Chisfamily/GB-Link-USB-Hardware/hw/v1.4/GB-LINK-v1.4.pdf

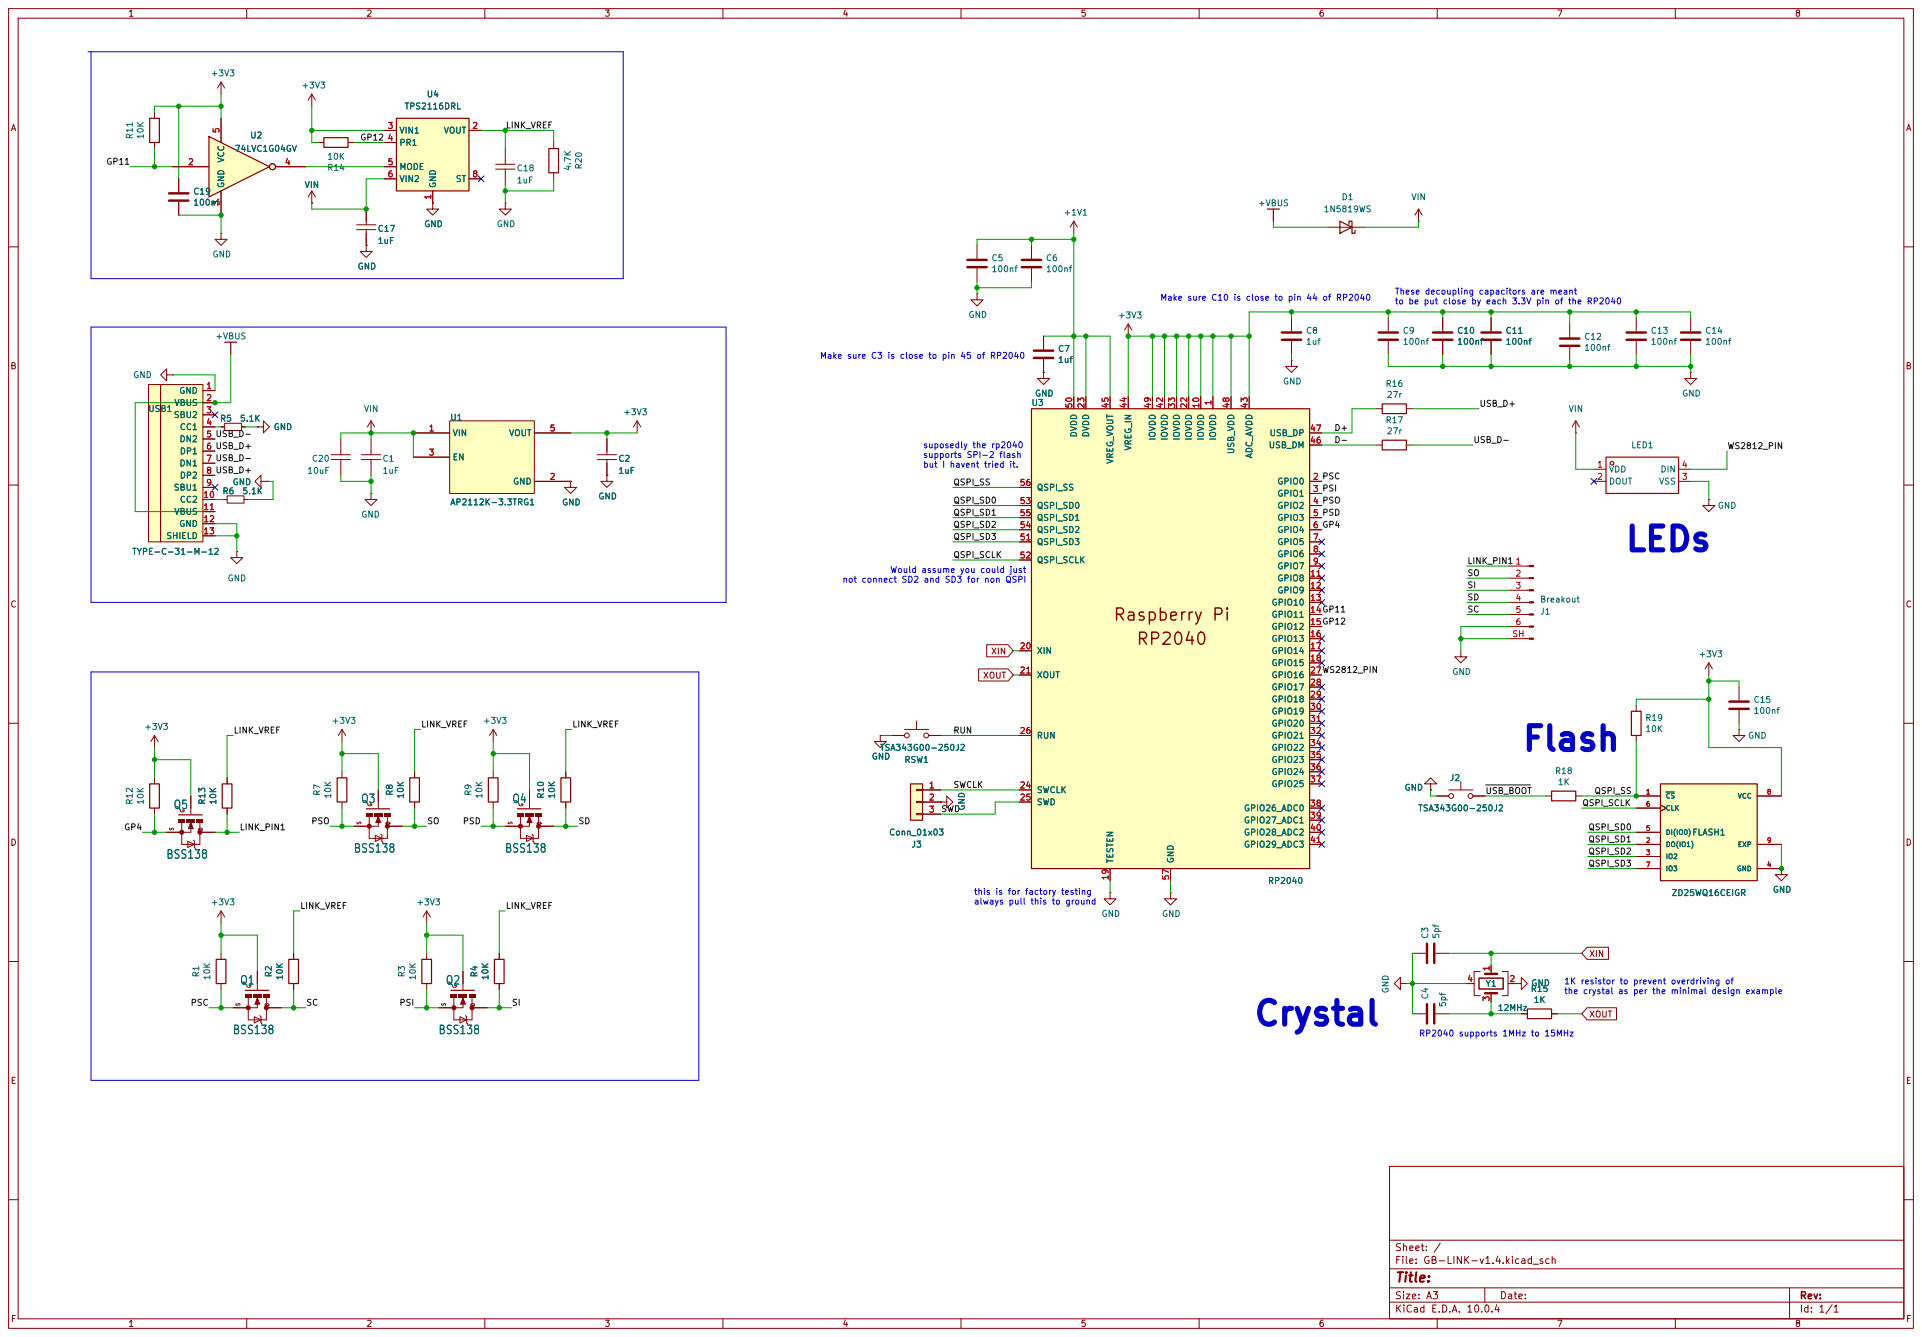
[picture p6: page 1]

These decoupling capacitors are meant
to be put close by each 3.3V pin of the RP2040

Crystal RP2040 supports 1MHz to 15MHz Would assume you could just not connect SD2 and SD3 for non QSPI Make sure C3 is close to pin 45 of RP2040

suposedly the rp2040
supports SPI-2 flash
but I havent tried it.

this is for factory testing
always pull this to ground

1K resistor to prevent overdriving of
the crystal as per the minimal design example

Size: A3 | Rev:
KiCad E.D.A. 10.0.4 | Id: 1/1 | F Date:
