Chisfamily/GB-Link-USB-Hardware/hw/v1.4/GB-LINK-v1.4.kicad_pcb

## KiCad design hw/v1.4/GB-LINK-v1.4.kicad_pcb (2026-10-19)

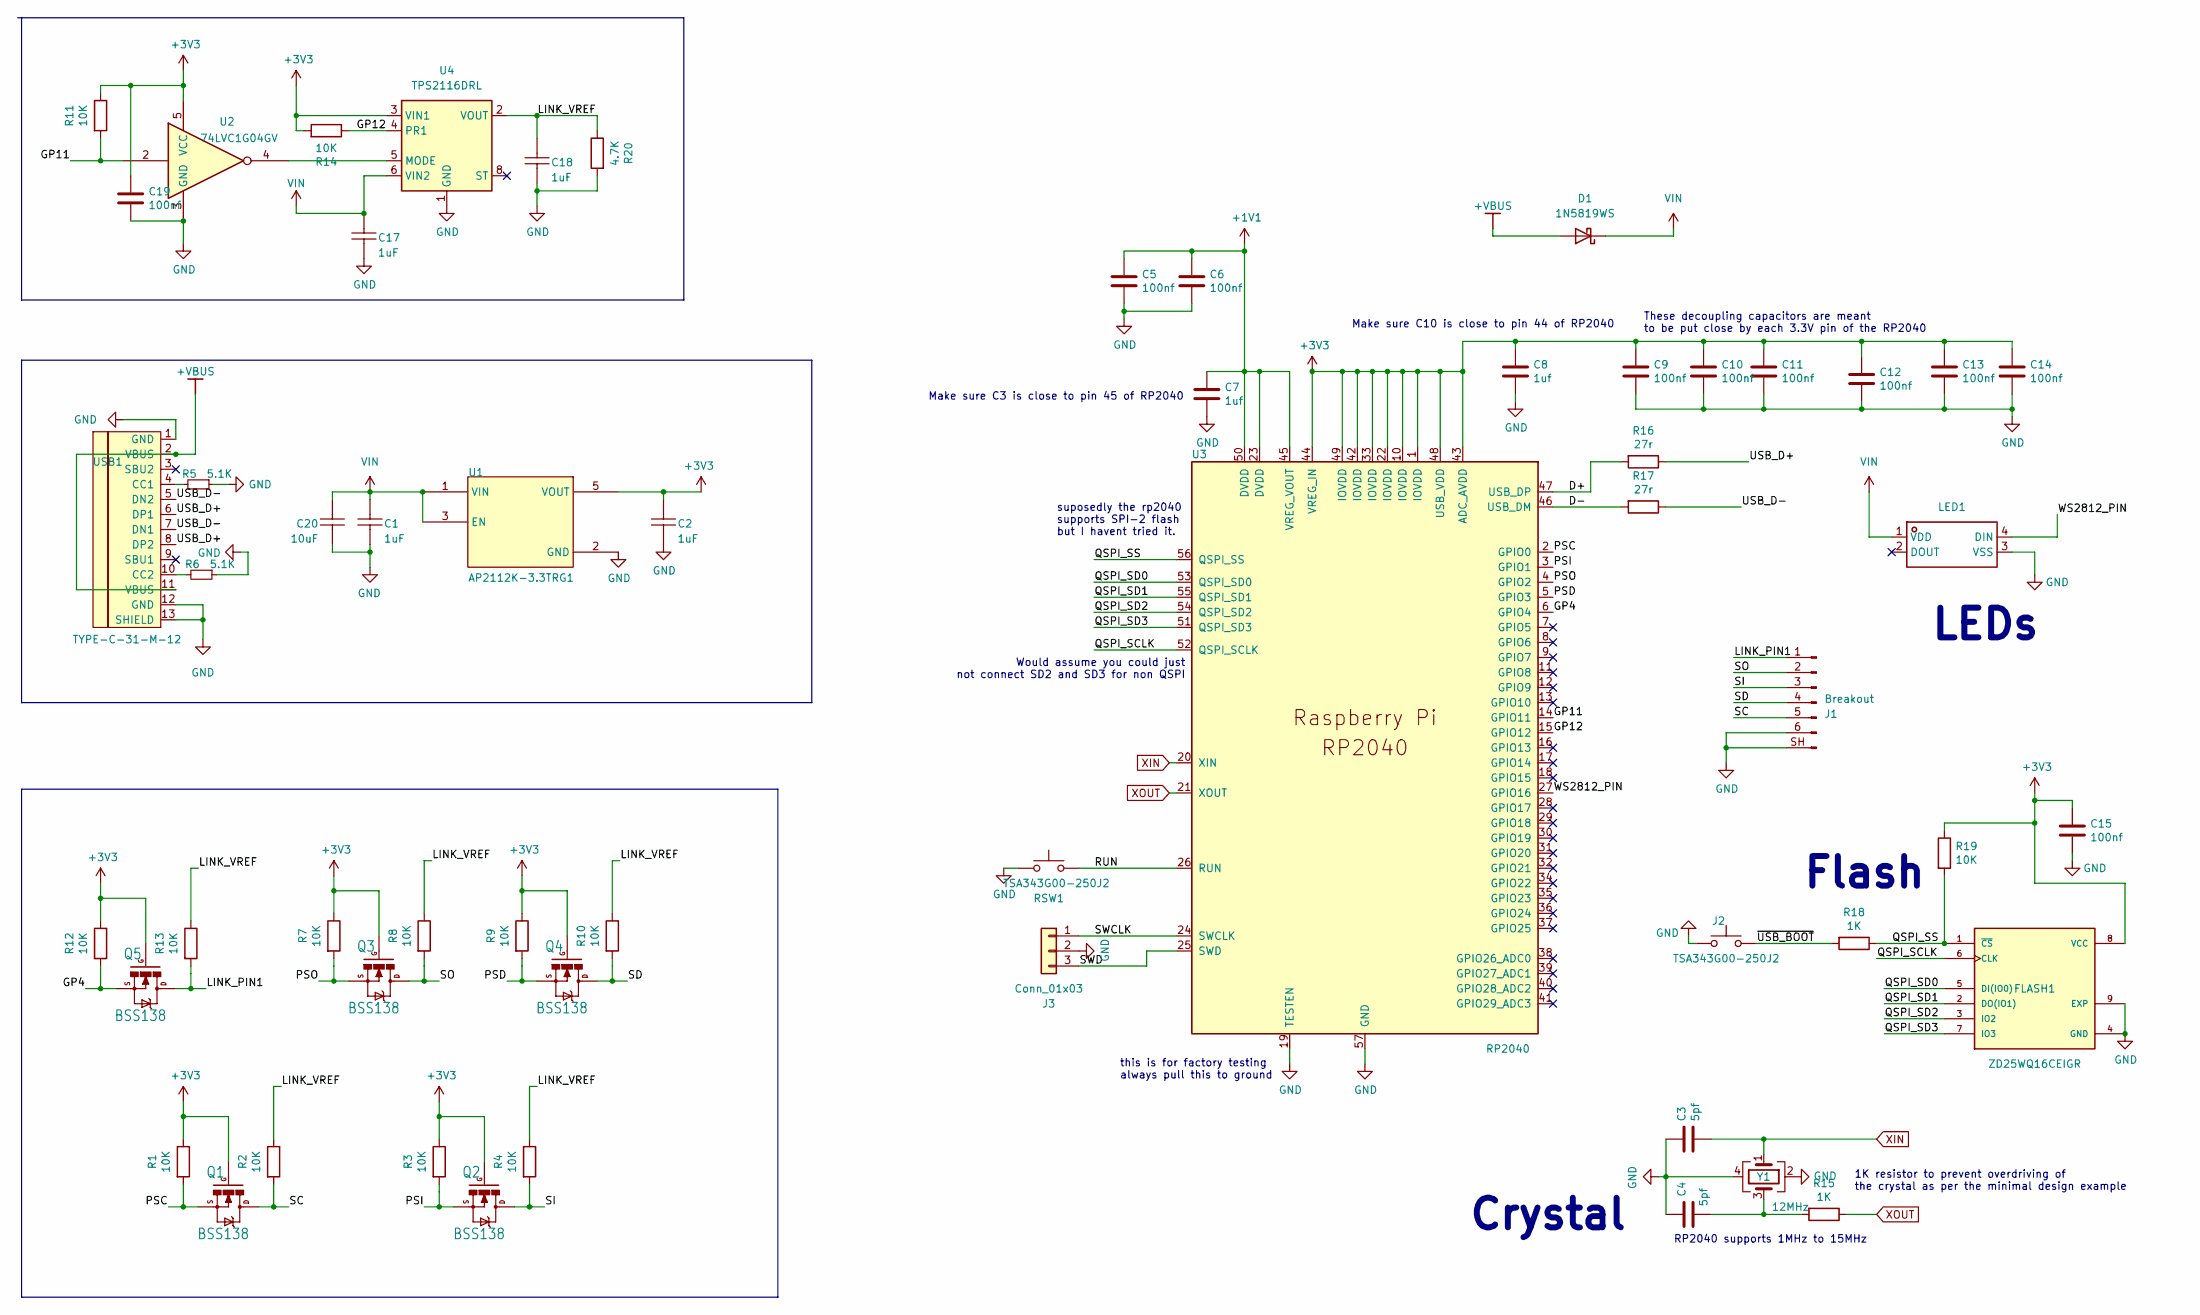
[picture p7: schematic GB-LINK-v1.4.kicad_sch]

Parts:
C1, C2, C17, C18: 1uF; C_0402_1005Metric; TOLERANCE 10%; VOLTAGE RATING 25V; MANUFACTURER PART NUMBER C1005X5R1E105K050BC
C3, C4: 5pf; C_0402_1005Metric
C5, C6, C9, C10, C11, C12, C13, C14, C15, C19: 100nf; C_0402_1005Metric
C7, C8: 1uf; C_0402_1005Metric
C20: 10uF; C_0603_1608Metric; TOLERANCE 10%; VOLTAGE RATING 25V; MANUFACTURER PART NUMBER C1005X5R1E105K050BC
D1: 1N5819WS; D_SOD-323
FLASH1: ZD25WQ16CEIGR; Winbond_USON-8-1EP_3x2mm_P0.5mm_EP0.2x1.6mm
J1: Breakout; gba_linkport
J2: TSA343G00-250J2; SW_Push_SPST_NO_Alps_SKRK
J3: Conn_01x03; PinHeader_1x03_P2.00mm_Vertical
LED1: LED_WS2812B-Mini_PLCC4_3.5x3.5mm
Q1, Q2, Q3, Q4, Q5: BSS138; SOT-23-3
R1, R2, R3, R4, R7, R8, R9, R10, R11, R12, R13, R14, R19: 10K; R_0402_1005Metric
R5, R6: 5.1K; R_0402_1005Metric
R15, R18: 1K; R_0402_1005Metric
R16, R17: 27r; R_0402_1005Metric
R20: 4.7K; R_0402_1005Metric
RSW1: TSA343G00-250J2; SW_Push_SPST_NO_Alps_SKRK
U1: AP2112K-3.3TRG1; SOT-23-5; DROPOUT VOLTAGE 250mV; OUTPUT VOLTAGE 3.3V; MANUFACTURER PART NUMBER AP2112K-3.3TRG1
U2: 74LVC1G04GV; SOT-23-5
U3: RP2040; RP2040-QFN-56; LCSC C2040
U4: TPS2116DRL; SOT-583-8
USB1: TYPE-C-31-M-12; HRO-TYPE-C-31-M-12; LCSC C165948
Y1: 12MHz; Crystal_SMD_3225-4Pin_3.2x2.5mm

Connections:
+1V1: C5.1, C6.1, C7.1, U3.23 (DVDD), U3.45 (VREG_VOUT), U3.50 (DVDD)
+3V3: C2.2, C8.1, C9.1, C10.1, C11.1, C12.1, C13.1, C14.1, C15.1, C19.1, FLASH1.8 (VCC), Q1.1 (G), Q2.1 (G), Q3.1 (G), Q4.1 (G), Q5.1 (G), R1.1, R3.1, R7.1, R9.1, R11.1, R12.1, R14.2, R19.1, U1.5 (VOUT), U2.5 (VCC), U3.1 (IOVDD), U3.10 (IOVDD), U3.22 (IOVDD), U3.33 (IOVDD), U3.42 (IOVDD), U3.43 (ADC_AVDD), U3.44 (VREG_IN), U3.48 (USB_VDD), U3.49 (IOVDD), U4.3 (VIN1)
+VBUS: D1.2 (A), USB1.2 (VBUS), USB1.11 (VBUS)
/D+: R16.2, U3.47 (USB_DP)
/D-: R17.2, U3.46 (USB_DM)
/GP4: Q5.2 (S), R12.2, U3.6 (GPIO4)
/GP11: R11.2, U2.2, U3.14 (GPIO11)
/GP12: R14.1, U3.15 (GPIO12), U4.4 (PR1)
/LINK_PIN1: J1.1, Q5.3 (D), R13.2
/LINK_VREF: C18.2, R2.1, R4.1, R8.1, R10.1, R13.1, R20.1, U4.2 (VOUT), U4.7 (VOUT)
/PSC: Q1.2 (S), R1.2, U3.2 (GPIO0)
/PSD: Q4.2 (S), R9.2, U3.5 (GPIO3)
/PSI: Q2.2 (S), R3.2, U3.3 (GPIO1)
/PSO: Q3.2 (S), R7.2, U3.4 (GPIO2)
/QSPI_SCLK: FLASH1.6 (CLK), U3.52 (QSPI_SCLK)
/QSPI_SD0: FLASH1.5 (DI(IO0)), U3.53 (QSPI_SD0)
/QSPI_SD1: FLASH1.2 (DO(IO1)), U3.55 (QSPI_SD1)
/QSPI_SD2: FLASH1.3 (IO2), U3.54 (QSPI_SD2)
/QSPI_SD3: FLASH1.7 (IO3), U3.51 (QSPI_SD3)
/QSPI_SS: FLASH1.1 (~CS), R18.1, R19.2, U3.56 (QSPI_SS)
/RUN: RSW1.2, U3.26 (RUN)
/SC: J1.5, Q1.3 (D), R2.2
/SD: J1.4, Q4.3 (D), R10.2
/SI: J1.3, Q2.3 (D), R4.2
/SO: J1.2, Q3.3 (D), R8.2
/SWCLK: J3.1, U3.24 (SWCLK)
/SWD: J3.3, U3.25 (SWD)
/USB_D+: R16.1, USB1.6 (DP1), USB1.8 (DP2)
/USB_D-: R17.1, USB1.5 (DN2), USB1.7 (DN1)
/WS2812_PIN: LED1.4 (DIN), U3.27 (GPIO16)
/~USB_BOOT: J2.1, R18.2
GND: C1.1, C2.1, C3.1, C4.1, C5.2, C6.2, C7.2, C8.2, C9.2, C10.2, C11.2, C12.2, C13.2, C14.2, C15.2, C17.1, C18.1, C19.2, C20.1, FLASH1.4 (GND), FLASH1.9 (EXP), J1.6, J1.SH (Pin_7), J2.2, J3.2, LED1.3 (VSS), R5.1, R6.1, R20.2, RSW1.1, U1.2 (GND), U2.3 (GND), U3.19 (TESTEN), U3.57 (GND), U4.1 (GND), USB1.1 (GND), USB1.12 (GND), USB1.13 (SHIELD), Y1.2, Y1.4
unnamed: C4.2, R15.2, Y1.3
unnamed: U2.4, U4.5 (MODE)
unnamed: R5.2, USB1.4 (CC1)
unnamed: R6.2, USB1.10 (CC2)
VIN: C1.2, C17.2, C20.2, D1.1 (K), LED1.1 (VDD), U1.1 (VIN), U1.3 (EN), U4.6 (VIN2)
XIN: C3.2, U3.20 (XIN), Y1.1
XOUT: R15.1, U3.21 (XOUT)

Notes on the sheet:
These decoupling capacitors are meant to be put close by each 3.3V pin of the RP2040
this is for factory testing always pull this to ground
suposedly the rp2040 supports SPI-2 flash but I havent tried it.
1K resistor to prevent overdriving of the crystal as per the minimal design example
LEDs
Crystal
Flash
RP2040 supports 1MHz to 15MHz
Make sure C3 is close to pin 45 of RP2040
Make sure C10 is close to pin 44 of RP2040
Would assume you could just not connect SD2 and SD3 for non QSPI

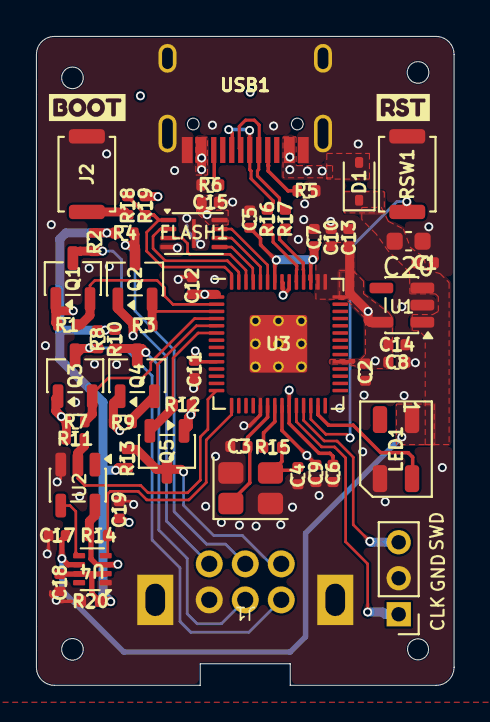
[picture p8: board GB-LINK-v1.4.kicad_pcb from above]

Board: 4 copper layers, 23.2 x 36.0 mm, 59 parts (0 on the bottom side), 39 nets.

Other parts of the board:
kibuzzard-6A85AEF8: G***; kibuzzard-6A85AEF8
kibuzzard-6A85AF09: G***; kibuzzard-6A85AF09
