Chisfamily/GB-Link-USB-Hardware/(commit log)

2026-10-19 hw: add GB-Link v1.4 design and document v1.4 changes
    - add hw/v1.4 KiCad 10 schematic, PCB, schematic PDF and footprint library
    - document the v1.4 changes against v1.0: TPS2116 Link-interface power mux,
    level-shifted Link connector pin 1 line, four-layer stack-up, netlist,
    BOM and manufacturing differences
    - update hardware features, repository layout and manufacturing notes
    - ignore KiCad lock files, local settings and backup archives
    - hw/v1.0 is unchanged
2026-10-19 docs(readme): show v1.4 renders and document GBC/GBA support
    - replace the single top view with v1.4 top and bottom renders
    - state that the documented board is v1.4 and works with GBC and GBA
    - note that Link-interface power adapts automatically, with no jumper,
    DIP switch or mechanical voltage switch on the board
